laurapreidewe/Agriculture-VCU_v2/UGV Control Unit.kicad_pcb

## KiCad design UGV Control Unit.kicad_pcb (2026-10-22)

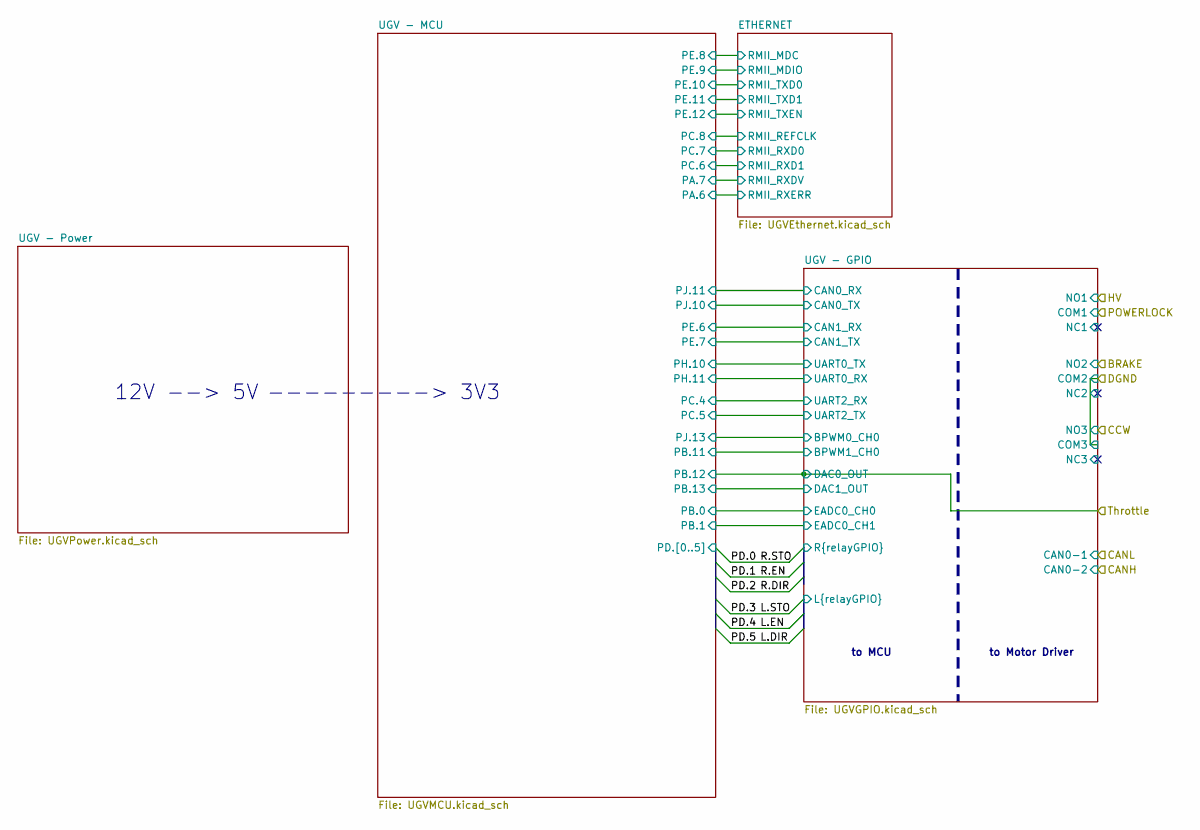
[picture p30: schematic UGV Control Unit.kicad_sch, Agricultural VCU V2]

Notes on the sheet:
to MCU
to Motor Driver
12V --> 5V
---------> 3V3

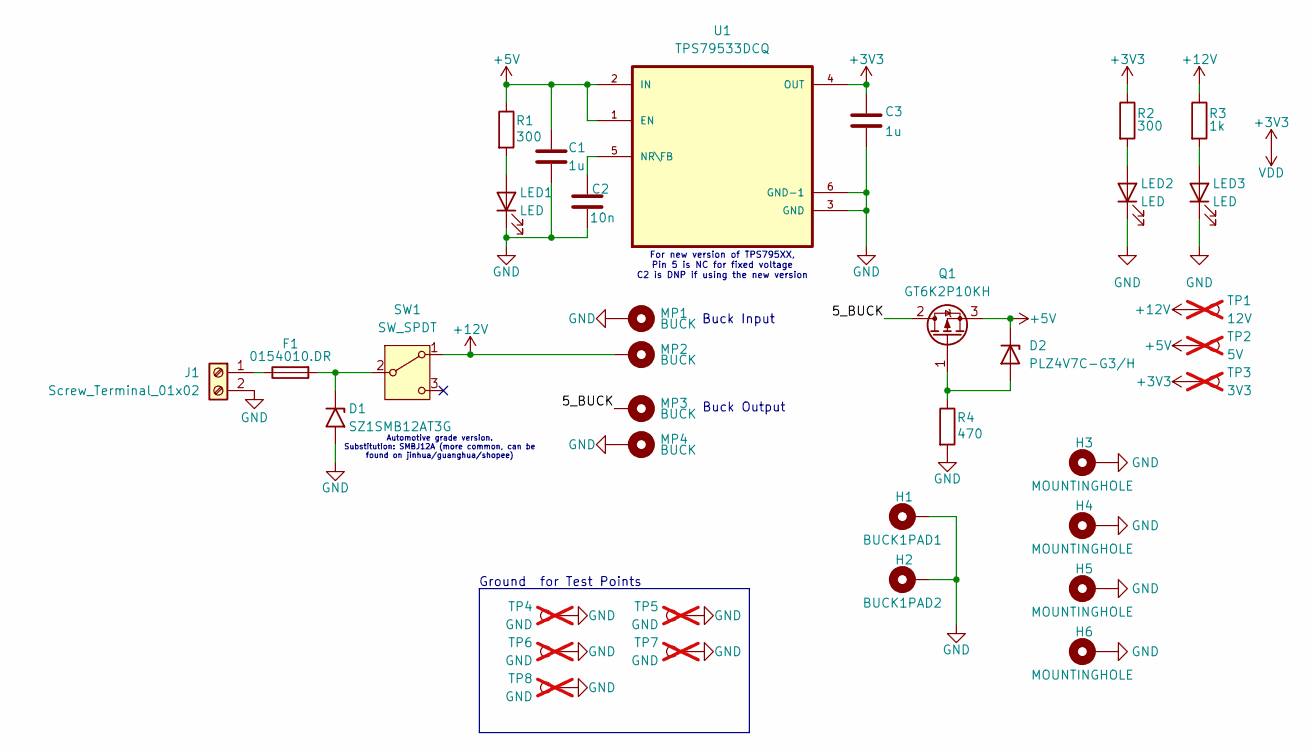
[picture p31: schematic UGVPower.kicad_sch, Agricultural VCU V2 - Power Supply]

Parts:
C1, C3: 1u; C_0603_1608Metric_Pad1.08x0.95mm_HandSolder; MANUFACTURER_PART_NUMBER 0603YC105JAT2A
C2: 10n; C_0603_1608Metric_Pad1.08x0.95mm_HandSolder; MANUFACTURER_PART_NUMBER KGM15AR51E103KT
D1: SZ1SMB12AT3G; D_SMB_Handsoldering; MANUFACTURER_PART_NUMBER SZ1SMB12AT3G
D2: PLZ4V7C-G3/H; CR_PLZ5V1C_VIS-L; MANUFACTURER_PART_NUMBER PLZ4V7C
F1: 0154010.DR; Fuseholder_Littelfuse_Nano2_154x; MANUFACTURER_PART_NUMBER 0154010.DR
H1: BUCK1PAD1; MountingHole_3.2mm_M3_Pad_TopBottom
H2: BUCK1PAD2; MountingHole_3.2mm_M3_Pad_TopBottom
H3, H4, H5, H6: MOUNTINGHOLE; MountingHole_3.2mm_M3_Pad_Via
J1: Screw_Terminal_01x02; TerminalBlock_TE_NC6-P107-02_1x02_P9.53mm; MANUFACTURER_PART_NUMBER 1437664-4
LED1, LED2, LED3: LED; LED_0603_1608Metric_Pad1.05x0.95mm_HandSolder; MANUFACTURER_PART_NUMBER 150060SS75003
MP1, MP2, MP3, MP4: BUCK; MountingHole_4.3mm_M4_Pad_TopBottom; MANUFACTURER_PART_NUMBER 24885
Q1: GT6K2P10KH; TO-252-2; MANUFACTURER_PART_NUMBER GT6K2P10KH
R1, R2: 300; R_0603_1608Metric_Pad0.98x0.95mm_HandSolder; MANUFACTURER_PART_NUMBER RT0603BRD07300RL
R3: 1k; R_0603_1608Metric_Pad0.98x0.95mm_HandSolder; MANUFACTURER_PART_NUMBER RT0603FRE131KL
R4: 470; R_0603_1608Metric_Pad0.98x0.95mm_HandSolder; MANUFACTURER_PART_NUMBER RT0603FRE07470RL
SW1: SW_SPDT; SW_500SSP1S1M2REA; MANUFACTURER_PART_NUMBER 500SSP1S1M2REA
TP1: 12V; TestPoint_Pad_D1.0mm; not fitted
TP2: 5V; TestPoint_Pad_D1.0mm; not fitted
TP3: 3V3; TestPoint_Pad_D1.0mm; not fitted
TP4, TP5, TP6, TP7, TP8: GND; PinHeader_1x01_P2.54mm_Vertical; not fitted
U1: TPS79533DCQ; SOT127P706X180-6N; MANUFACTURER_PART_NUMBER TPS79533DCQ

Connections:
+12V: MP2.1, R3.1, SW1.1 (A), TP1.1; also elsewhere on the board
/UGV - Power/5_BUCK: MP3.1, Q1.2 (D)
GND: C1.2, C2.2, C3.2, D1.2 (A2), H1.1, H2.1, H3.1, H4.1, H5.1, H6.1, J1.2, LED1.1 (K), LED2.1 (K), LED3.1 (K), MP1.1, MP4.1, R4.2, TP4.1, TP5.1, TP6.1, TP7.1, TP8.1, U1.3 (GND), U1.6 (GND-1); also elsewhere on the board
unnamed: D1.1 (A1), F1.2, SW1.2 (B)
unnamed: D2.2 (A), Q1.1 (G), R4.1
unnamed: F1.1, J1.1
unnamed: LED1.2 (A), R1.2
unnamed: LED2.2 (A), R2.2
unnamed: LED3.2 (A), R3.2
unnamed: C2.1, U1.5 (NR\FB)

Notes on the sheet:
Automotive grade version. Substitution: SMBJ12A (more common, can be found on jinhua/guanghua/shopee)
Ground for Test Points
Buck Input
For new version of TPS795XX, Pin 5 is NC for fixed voltage C2 is DNP if using the new version
Buck Output

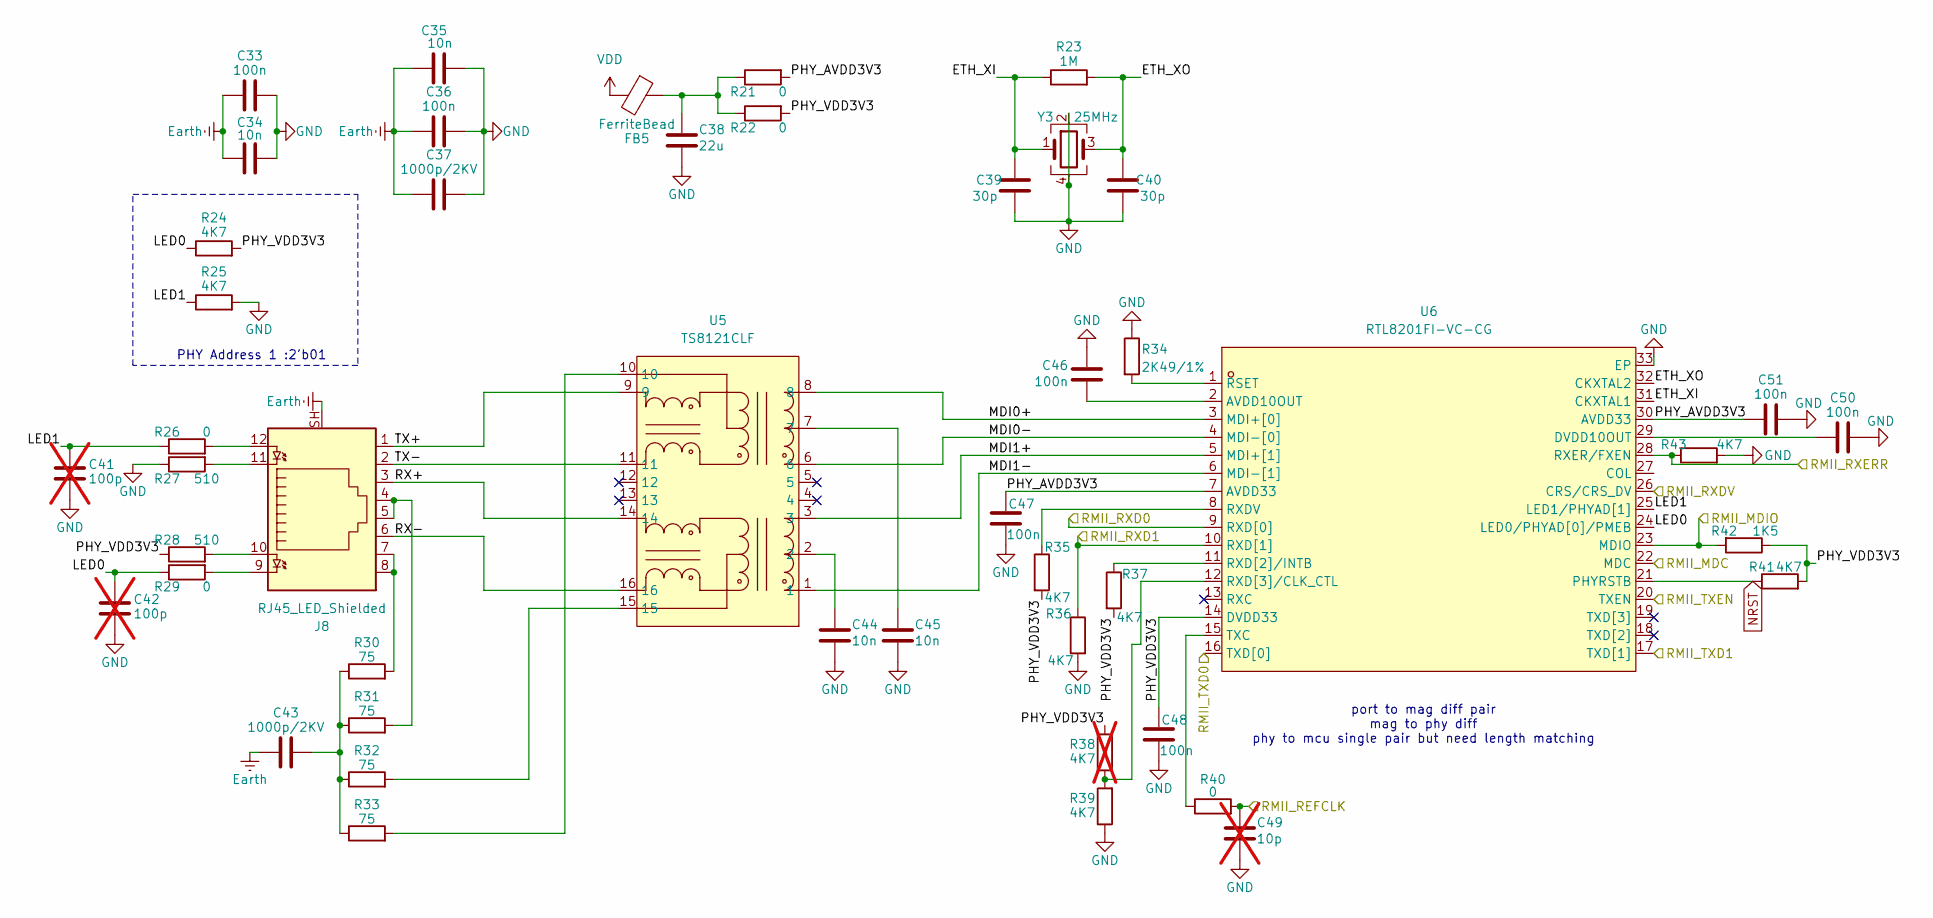
[picture p32: schematic UGVEthernet.kicad_sch, Agricultural VCU V2 - Ethernet]

Parts:
C33, C36, C46, C47, C48, C50, C51: 100n; C_0603_1608Metric_Pad1.08x0.95mm_HandSolder; MANUFACTURER_PART_NUMBER KGM15BR71H104KT
C34, C35, C44, C45: 10n; C_0603_1608Metric_Pad1.08x0.95mm_HandSolder; MANUFACTURER_PART_NUMBER KGM15AR51E103KT
C37, C43: 1000p/2KV; C_1206_3216Metric_Pad1.33x1.80mm_HandSolder; MANUFACTURER_PART_NUMBER CC1206JKX7RDBB102
C38: 22u; C_0603_1608Metric_Pad1.08x0.95mm_HandSolder; MANUFACTURER_PART_NUMBER GRM188R61A226ME15D
C39, C40: 30p; C_0603_1608Metric_Pad1.08x0.95mm_HandSolder; MANUFACTURER_PART_NUMBER 06035A300JAT2A
C41, C42: 100p; C_0603_1608Metric_Pad1.08x0.95mm_HandSolder; MANUFACTURER_PART_NUMBER KGM15ACG1H101FT; not fitted
C49: 10p; C_0603_1608Metric_Pad1.08x0.95mm_HandSolder; MANUFACTURER_PART_NUMBER CC0603JRNPO9BN100; not fitted
FB5: FerriteBead; L_0603_1608Metric_Pad1.05x0.95mm_HandSolder; MANUFACTURER_PART_NUMBER BLM18KG300TN1D
J8: RJ45_LED_Shielded; RJ45_Amphenol_RJHSE538X; MANUFACTURER_PART_NUMBER RJHSE5381
R21, R22, R26, R29, R40: 0; R_0603_1608Metric_Pad0.98x0.95mm_HandSolder; MANUFACTURER_PART_NUMBER RC0603JR-070RL
R23: 1M; R_0603_1608Metric_Pad0.98x0.95mm_HandSolder; MANUFACTURER_PART_NUMBER RC0603FR-101ML
R24, R25, R35, R36, R37, R39, R41, R43: 4K7; R_0603_1608Metric_Pad0.98x0.95mm_HandSolder; MANUFACTURER_PART_NUMBER RC0603FR-134K7L
R27, R28: 510; R_0603_1608Metric_Pad0.98x0.95mm_HandSolder; MANUFACTURER_PART_NUMBER RT0603BRD07510RL
R30, R31, R32, R33: 75; R_0603_1608Metric_Pad0.98x0.95mm_HandSolder; MANUFACTURER_PART_NUMBER RC0603FR-0775RL
R34: 2K49/1%; R_0603_1608Metric_Pad0.98x0.95mm_HandSolder; MANUFACTURER_PART_NUMBER RC0603FR-072K49L
R38: 4K7; R_0603_1608Metric_Pad0.98x0.95mm_HandSolder; MANUFACTURER_PART_NUMBER RC0603FR-134K7L; not fitted
R42: 1K5; R_0603_1608Metric_Pad0.98x0.95mm_HandSolder; MANUFACTURER_PART_NUMBER RT0603FRE071K5L
U5: TS8121CLF; SOP-16_7.0x13.0mm_P1.27mm; MANUFACTURER_PART_NUMBER TS8121CLF; LCSC Part C2839017
U6: RTL8201FI-VC-CG; QFN-32-1EP_5x5mm_P0.5mm_EP3.3x3.3mm_ThermalVias; MANUFACTURER_PART_NUMBER RTL8201FI-VC-CG; LCSC Part C2763557
Y3: 25MHz; Crystal_SMD_SeikoEpson_TSX3225-4Pin_3.2x2.5mm_HandSoldering; MANUFACTURER_PART_NUMBER TSX-3225 25.0000MF10P-C0

Connections:
/ETHERNET/ETH_XI: C39.1, R23.1, U6.31 (CKXTAL1), Y3.1
/ETHERNET/ETH_XO: C40.1, R23.2, U6.32 (CKXTAL2), Y3.3
/ETHERNET/LED0: C42.1, R24.1, R29.1, U6.24 (LED0/PHYAD[0]/PMEB)
/ETHERNET/LED1: C41.1, R25.1, R26.1, U6.25 (LED1/PHYAD[1])
/ETHERNET/MDI0+: U5.8, U6.3 (MDI+[0])
/ETHERNET/MDI0-: U5.6, U6.4 (MDI-[0])
/ETHERNET/MDI1+: U5.3, U6.5 (MDI+[1])
/ETHERNET/MDI1-: U5.1, U6.6 (MDI-[1])
/ETHERNET/PHY_AVDD3V3: C47.1, C51.2, R21.2, U6.7 (AVDD33), U6.30 (AVDD33)
/ETHERNET/PHY_VDD3V3: C48.1, R22.2, R24.2, R28.1, R35.2, R37.2, R38.2, R41.2, R42.1, U6.14 (DVDD33)
/ETHERNET/RX+: J8.3, U5.14
/ETHERNET/RX-: J8.6, U5.16
/ETHERNET/TX+: J8.1, U5.9
/ETHERNET/TX-: J8.2, U5.11
/UGV - MCU/PA.6: R43.1, U6.28 (RXER/FXEN); also elsewhere on the board
/UGV - MCU/PA.7: U6.26 (CRS/CRS_DV); also elsewhere on the board
/UGV - MCU/PC.6: R36.1, U6.10 (RXD[1]); also elsewhere on the board
/UGV - MCU/PC.7: U6.9 (RXD[0]); also elsewhere on the board
/UGV - MCU/PC.8: C49.1, R40.2; also elsewhere on the board
/UGV - MCU/PE.8: U6.22 (MDC); also elsewhere on the board
/UGV - MCU/PE.9: R42.2, U6.23 (MDIO); also elsewhere on the board
/UGV - MCU/PE.10: U6.16 (TXD[0]); also elsewhere on the board
/UGV - MCU/PE.11: U6.17 (TXD[1]); also elsewhere on the board
/UGV - MCU/PE.12: U6.20 (TXEN); also elsewhere on the board
Earth: C33.1, C34.2, C35.1, C36.2, C37.1, C43.1, J8.SH
GND: C33.2, C34.1, C35.2, C36.1, C37.2, C38.2, C39.2, C40.2, C41.2, C42.2, C44.2, C45.2, C46.1, C47.2, C48.2, C49.2, C50.1, C51.1, R25.2, R27.1, R34.1, R36.2, R39.1, R43.2, U6.33 (EP), Y3.2, Y3.4; also elsewhere on the board
NRST: R41.1, U6.21 (PHYRSTB); also elsewhere on the board
unnamed: C38.1, FB5.1, R21.1, R22.1
unnamed: C43.2, R30.1, R31.1, R32.1, R33.1
unnamed: C44.1, U5.2
unnamed: C45.1, U5.7
unnamed: J8.4, J8.5, R31.2
unnamed: J8.7, J8.8, R30.2
unnamed: J8.9, R29.2
unnamed: J8.10, R28.2
unnamed: J8.11, R27.2
unnamed: J8.12, R26.2
unnamed: R32.2, U5.15
unnamed: R33.2, U5.10
unnamed: C46.2, U6.2 (AVDD10OUT)
unnamed: C50.2, U6.29 (DVDD10OUT)
unnamed: R34.2, U6.1 (RSET)
unnamed: R35.1, U6.8 (RXDV)
unnamed: R37.1, U6.11 (RXD[2]/INTB)
unnamed: R38.1, R39.2, U6.12 (RXD[3]/CLK_CTL)
unnamed: R40.1, U6.15 (TXC)

Notes on the sheet:
port to mag diff pair mag to phy diff phy to mcu single pair but need length matching
PHY Address 1 :2'b01

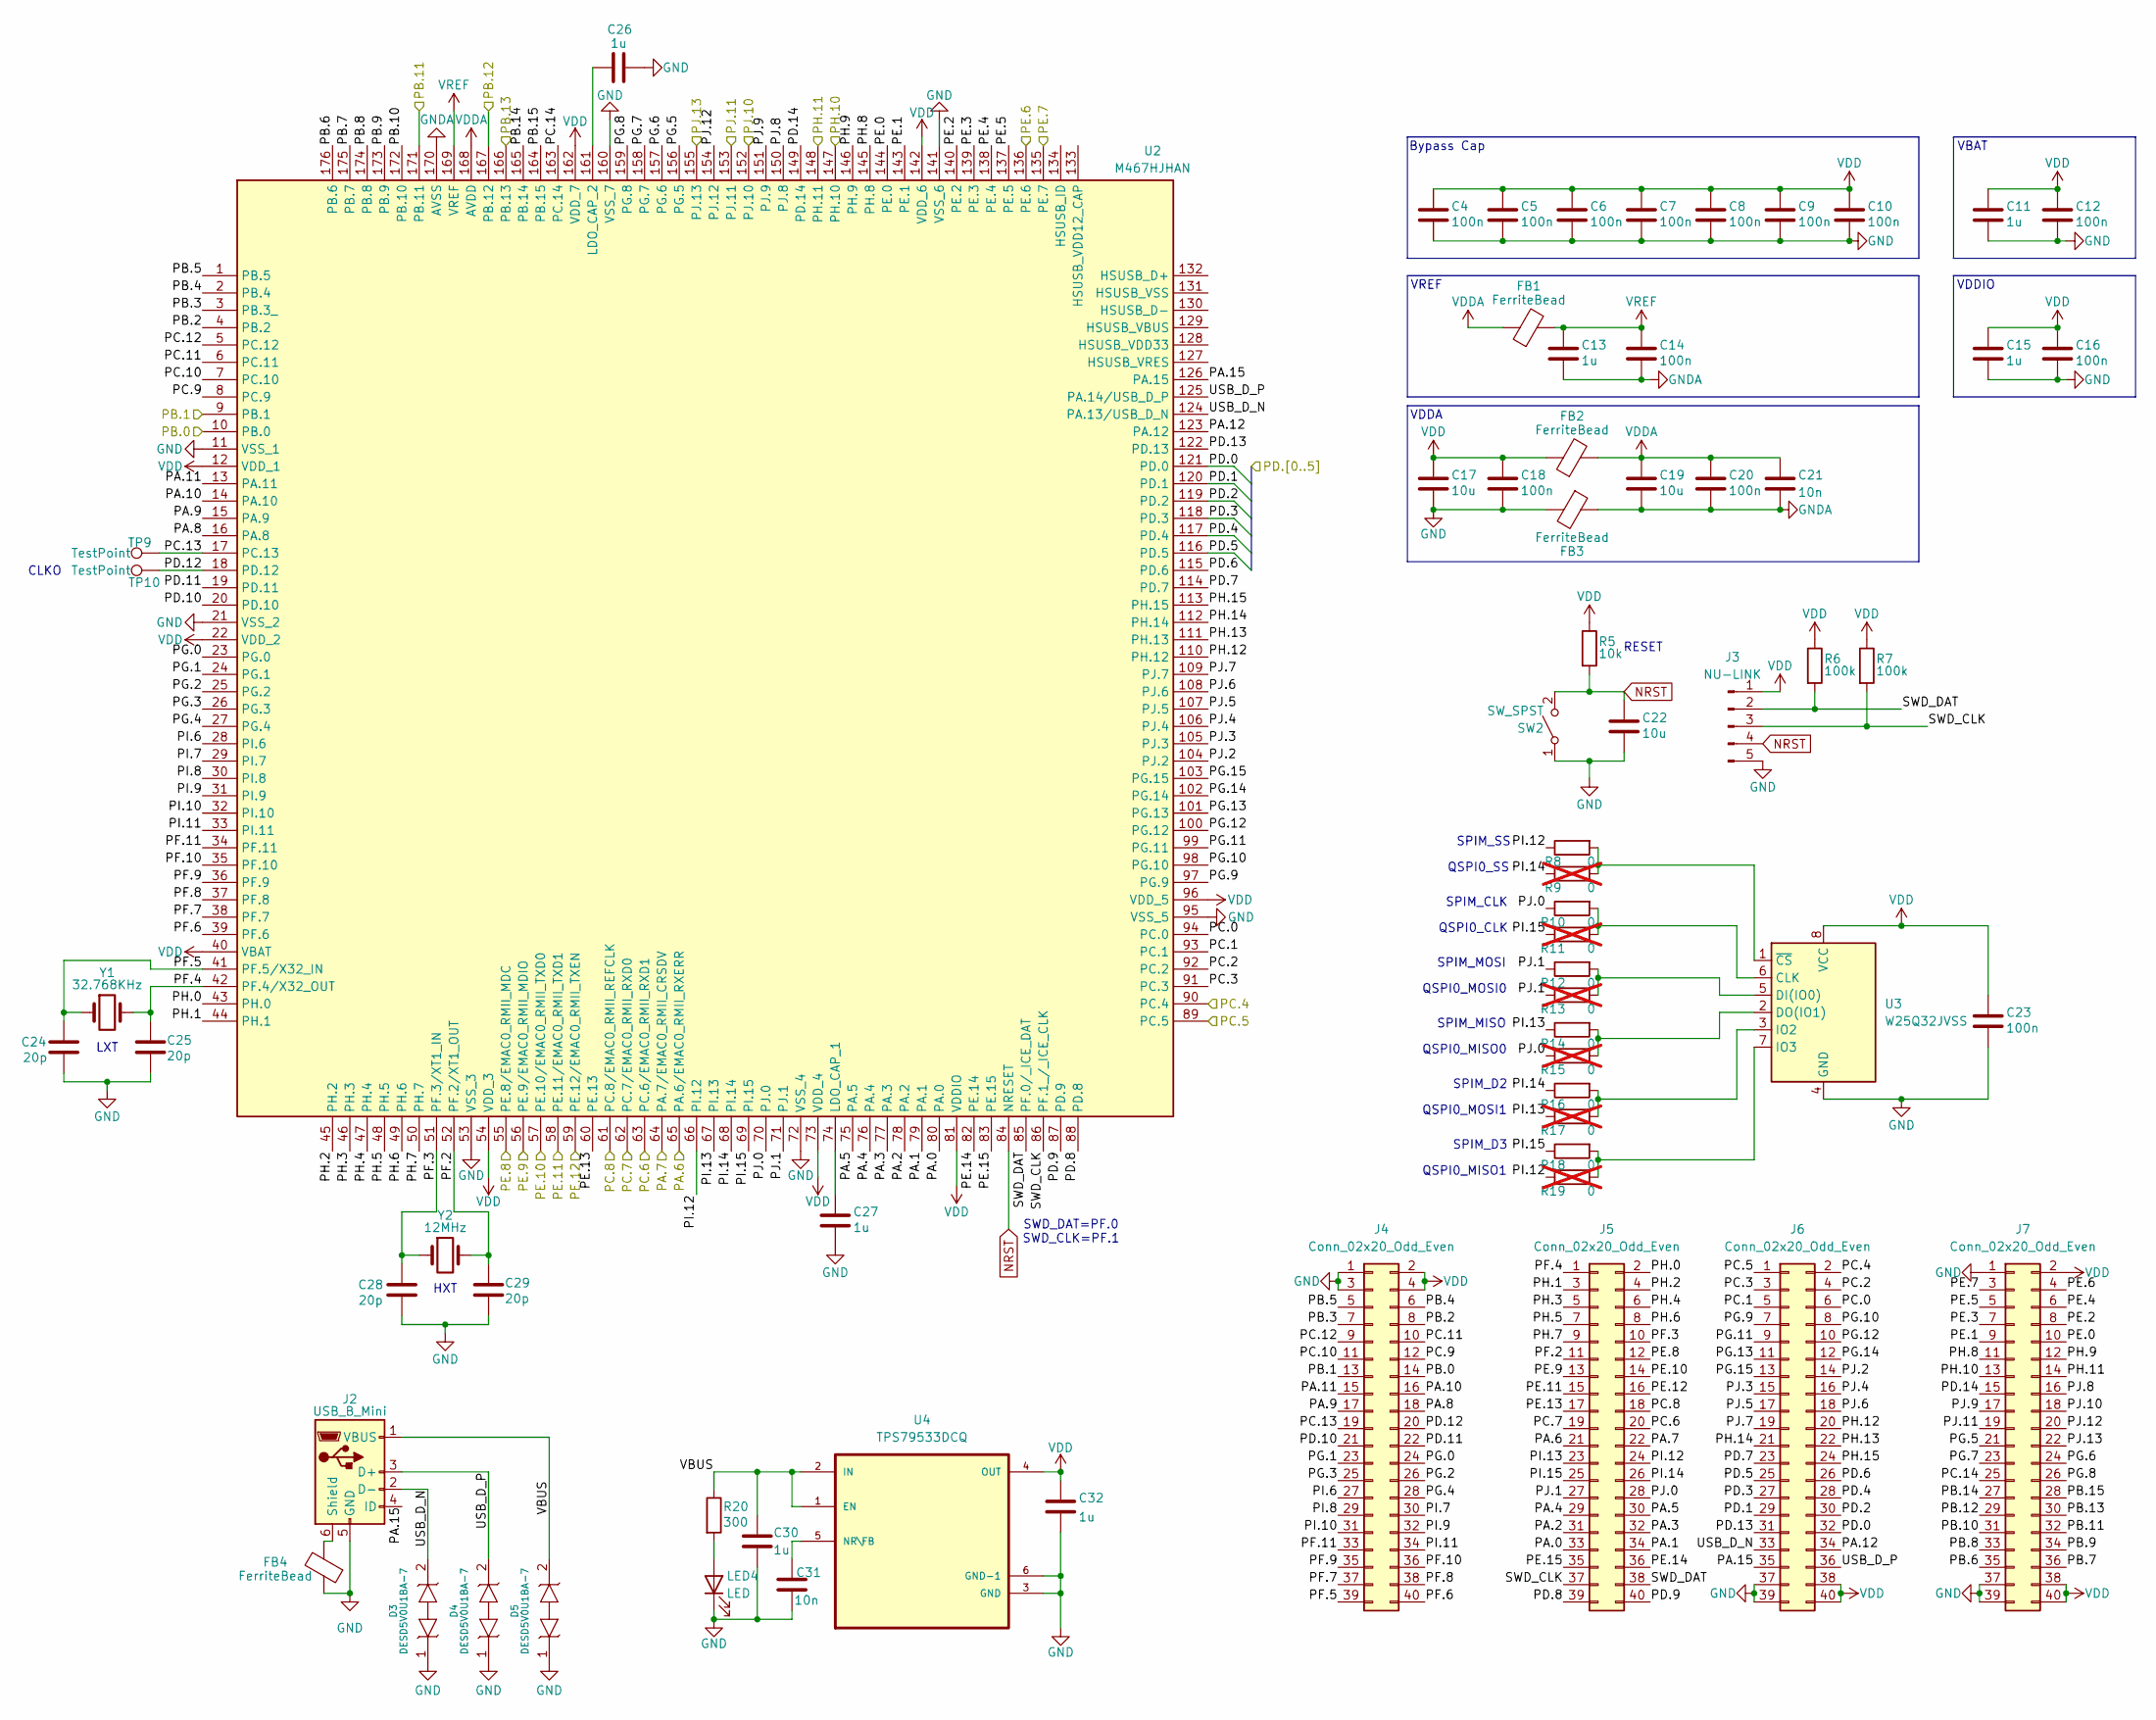
[picture p33: schematic UGVMCU.kicad_sch, Agricultural VCU V2 - MCU]

Parts:
C4, C5, C6, C7, C8, C9, C10, C12, C14, C16, C18, C20, C23: 100n; C_0603_1608Metric_Pad1.08x0.95mm_HandSolder; MANUFACTURER_PART_NUMBER KGM15BR71H104KT
C11, C13, C15, C26, C27, C30, C32: 1u; C_0603_1608Metric_Pad1.08x0.95mm_HandSolder; MANUFACTURER_PART_NUMBER 0603YC105JAT2A
C17, C19, C22: 10u; C_0603_1608Metric_Pad1.08x0.95mm_HandSolder; MANUFACTURER_PART_NUMBER GRM188D71A106KA73D
C21, C31: 10n; C_0603_1608Metric_Pad1.08x0.95mm_HandSolder; MANUFACTURER_PART_NUMBER KGM15AR51E103KT
C24, C25, C28, C29: 20p; C_0603_1608Metric_Pad1.08x0.95mm_HandSolder; MANUFACTURER_PART_NUMBER 06035A200JAT2A
D3, D4, D5: DESD5V0U1BA-7; SOD323-L_DIO; MANUFACTURER_PART_NUMBER DESD5V0U1BA
FB1, FB2, FB3, FB4: FerriteBead; L_0603_1608Metric_Pad1.05x0.95mm_HandSolder; MANUFACTURER_PART_NUMBER BLM18KG300TN1D
J2: USB_B_Mini; USB_Mini-B_Wuerth_65100516121_Horizontal; MANUFACTURER_PART_NUMBER 1734035-3
J3: NU-LINK; PinHeader_1x05_P2.54mm_Vertical; MANUFACTURER_PART_NUMBER PH1-05-UA
J4, J5, J6, J7: Conn_02x20_Odd_Even; PinSocket_2x20_P2.54mm_Vertical
LED4: LED; LED_0603_1608Metric_Pad1.05x0.95mm_HandSolder; MANUFACTURER_PART_NUMBER 150060SS75003
R5: 10k; R_0603_1608Metric_Pad0.98x0.95mm_HandSolder; MANUFACTURER_PART_NUMBER RT0603FRE0710KL
R6, R7: 100k; R_0603_1608Metric_Pad0.98x0.95mm_HandSolder; MANUFACTURER_PART_NUMBER RT0603BRE07100KL
R8, R10, R12, R14, R16, R18: 0; R_0603_1608Metric_Pad0.98x0.95mm_HandSolder; MANUFACTURER_PART_NUMBER RC0603JR-070RL
R9, R11, R13, R15, R17, R19: 0; R_0603_1608Metric_Pad0.98x0.95mm_HandSolder; MANUFACTURER_PART_NUMBER RC0603JR-070RL; not fitted
R20: 300; R_0603_1608Metric_Pad0.98x0.95mm_HandSolder; MANUFACTURER_PART_NUMBER RT0603BRD07300RL
SW2: SW_SPST; SW_PUSH_6mm; MANUFACTURER_PART_NUMBER TL1105F160QWITHSTRAIGHT
TP9, TP10: TestPoint; PinHeader_1x01_P2.54mm_Vertical
U2: M467HJHAN; LQFP-176_24x24mm_P0.5mm; Manufacturer_Part_Number M467HJHAN
U3: W25Q32JVSS; SOIC-8_5.23x5.23mm_P1.27mm; MANUFACTURER_PART_NUMBER W25Q32JVSSIQ
U4: TPS79533DCQ; SOT127P706X180-6N; MANUFACTURER_PART_NUMBER TPS79533DCQ
Y1: 32.768KHz; Crystal_SMD_EuroQuartz_EQ161-2Pin_3.2x1.5mm_HandSoldering; MANUFACTURER_PART_NUMBER ABS07-32.768KHZ-T
Y2: 12MHz; Crystal_HC49-4H_Vertical

Connections:
/UGV - GPIO/CAN0_RX: J7.19, U2.153 (PJ.11); also elsewhere on the board
/UGV - GPIO/CAN0_TX: J7.18, U2.152 (PJ.10); also elsewhere on the board
/UGV - GPIO/CAN1_RX: J7.4, U2.136 (PE.6); also elsewhere on the board
/UGV - GPIO/CAN1_TX: J7.3, U2.135 (PE.7); also elsewhere on the board
/UGV - GPIO/L.DIR: J6.25, U2.116 (PD.5); also elsewhere on the board
/UGV - GPIO/L.EN: J6.28, U2.117 (PD.4); also elsewhere on the board
/UGV - GPIO/L.STO: J6.27, U2.118 (PD.3); also elsewhere on the board
/UGV - GPIO/UART0_RX: J7.14, U2.148 (PH.11); also elsewhere on the board
/UGV - GPIO/UART0_TX: J7.13, U2.147 (PH.10); also elsewhere on the board
/UGV - GPIO/UART2_RX: J6.2, U2.90 (PC.4); also elsewhere on the board
/UGV - GPIO/UART2_TX: J6.1, U2.89 (PC.5); also elsewhere on the board
/UGV - MCU/PA.0: J5.33, U2.80 (PA.0)
/UGV - MCU/PA.1: J5.34, U2.79 (PA.1)
/UGV - MCU/PA.2: J5.31, U2.78 (PA.2)
/UGV - MCU/PA.3: J5.32, U2.77 (PA.3)
/UGV - MCU/PA.4: J5.29, U2.76 (PA.4)
/UGV - MCU/PA.5: J5.30, U2.75 (PA.5)
/UGV - MCU/PA.6: J5.21, U2.65 (PA.6/EMAC0_RMII_RXERR); also elsewhere on the board
/UGV - MCU/PA.7: J5.22, U2.64 (PA.7/EMAC0_RMII_CRSDV); also elsewhere on the board
/UGV - MCU/PA.8: J4.18, U2.16 (PA.8)
/UGV - MCU/PA.9: J4.17, U2.15 (PA.9)
/UGV - MCU/PA.10: J4.16, U2.14 (PA.10)
/UGV - MCU/PA.11: J4.15, U2.13 (PA.11)
/UGV - MCU/PA.12: J6.34, U2.123 (PA.12)
/UGV - MCU/PA.15: J2.4 (ID), J6.35, U2.126 (PA.15)
/UGV - MCU/PB.0: J4.14, U2.10 (PB.0); also elsewhere on the board
/UGV - MCU/PB.1: J4.13, U2.9 (PB.1); also elsewhere on the board
/UGV - MCU/PB.2: J4.8, U2.4 (PB.2)
/UGV - MCU/PB.3: J4.7, U2.3 (PB.3_)
/UGV - MCU/PB.4: J4.6, U2.2 (PB.4)
/UGV - MCU/PB.5: J4.5, U2.1 (PB.5)
/UGV - MCU/PB.6: J7.35, U2.176 (PB.6)
/UGV - MCU/PB.7: J7.36, U2.175 (PB.7)
/UGV - MCU/PB.8: J7.33, U2.174 (PB.8)
/UGV - MCU/PB.9: J7.34, U2.173 (PB.9)
/UGV - MCU/PB.10: J7.31, U2.172 (PB.10)
/UGV - MCU/PB.11: J7.32, U2.171 (PB.11); also elsewhere on the board
/UGV - MCU/PB.12: J7.29, U2.167 (PB.12); also elsewhere on the board
/UGV - MCU/PB.13: J7.30, U2.166 (PB.13); also elsewhere on the board
/UGV - MCU/PB.14: J7.27, U2.165 (PB.14)
/UGV - MCU/PB.15: J7.28, U2.164 (PB.15)
/UGV - MCU/PC.0: J6.6, U2.94 (PC.0)
/UGV - MCU/PC.1: J6.5, U2.93 (PC.1)
/UGV - MCU/PC.2: J6.4, U2.92 (PC.2)
/UGV - MCU/PC.3: J6.3, U2.91 (PC.3)
/UGV - MCU/PC.6: J5.20, U2.63 (PC.6/EMAC0_RMII_RXD1); also elsewhere on the board
/UGV - MCU/PC.7: J5.19, U2.62 (PC.7/EMAC0_RMII_RXD0); also elsewhere on the board
/UGV - MCU/PC.8: J5.18, U2.61 (PC.8/EMAC0_RMII_REFCLK); also elsewhere on the board
/UGV - MCU/PC.9: J4.12, U2.8 (PC.9)
/UGV - MCU/PC.10: J4.11, U2.7 (PC.10)
/UGV - MCU/PC.11: J4.10, U2.6 (PC.11)
/UGV - MCU/PC.12: J4.9, U2.5 (PC.12)
/UGV - MCU/PC.13: J4.19, TP9.1, U2.17 (PC.13)
/UGV - MCU/PC.14: J7.25, U2.163 (PC.14)
/UGV - MCU/PD.0: J6.32, U2.121 (PD.0); also elsewhere on the board
/UGV - MCU/PD.1: J6.29, U2.120 (PD.1); also elsewhere on the board
/UGV - MCU/PD.2: J6.30, U2.119 (PD.2); also elsewhere on the board
/UGV - MCU/PD.6: J6.26, U2.115 (PD.6)
/UGV - MCU/PD.7: J6.23, U2.114 (PD.7)
/UGV - MCU/PD.8: J5.39, U2.88 (PD.8)
/UGV - MCU/PD.9: J5.40, U2.87 (PD.9)
/UGV - MCU/PD.10: J4.21, U2.20 (PD.10)
/UGV - MCU/PD.11: J4.22, U2.19 (PD.11)
/UGV - MCU/PD.12: J4.20, TP10.1, U2.18 (PD.12)
/UGV - MCU/PD.13: J6.31, U2.122 (PD.13)
/UGV - MCU/PD.14: J7.15, U2.149 (PD.14)
/UGV - MCU/PE.0: J7.10, U2.144 (PE.0)
/UGV - MCU/PE.1: J7.9, U2.143 (PE.1)
/UGV - MCU/PE.2: J7.8, U2.140 (PE.2)
/UGV - MCU/PE.3: J7.7, U2.139 (PE.3)
/UGV - MCU/PE.4: J7.6, U2.138 (PE.4)
/UGV - MCU/PE.5: J7.5, U2.137 (PE.5)
/UGV - MCU/PE.8: J5.12, U2.55 (PE.8/EMAC0_RMII_MDC); also elsewhere on the board
/UGV - MCU/PE.9: J5.13, U2.56 (PE.9/EMAC0_RMII_MDIO); also elsewhere on the board
/UGV - MCU/PE.10: J5.14, U2.57 (PE.10/EMAC0_RMII_TXD0); also elsewhere on the board
/UGV - MCU/PE.11: J5.15, U2.58 (PE.11/EMAC0_RMII_TXD1); also elsewhere on the board
/UGV - MCU/PE.12: J5.16, U2.59 (PE.12/EMAC0_RMII_TXEN); also elsewhere on the board
/UGV - MCU/PE.13: J5.17, U2.60 (PE.13)
/UGV - MCU/PE.14: J5.36, U2.82 (PE.14)
/UGV - MCU/PE.15: J5.35, U2.83 (PE.15)
/UGV - MCU/PF.2: C29.1, J5.11, U2.52 (PF.2/XT1_OUT), Y2.2
/UGV - MCU/PF.3: C28.1, J5.10, U2.51 (PF.3/XT1_IN), Y2.1
/UGV - MCU/PF.4: C25.1, J5.1, U2.42 (PF.4/X32_OUT), Y1.2
/UGV - MCU/PF.5: C24.1, J4.39, U2.41 (PF.5/X32_IN), Y1.1
/UGV - MCU/PF.6: J4.40, U2.39 (PF.6)
/UGV - MCU/PF.7: J4.37, U2.38 (PF.7)
/UGV - MCU/PF.8: J4.38, U2.37 (PF.8)
/UGV - MCU/PF.9: J4.35, U2.36 (PF.9)
/UGV - MCU/PF.10: J4.36, U2.35 (PF.10)
/UGV - MCU/PF.11: J4.33, U2.34 (PF.11)
/UGV - MCU/PG.0: J4.24, U2.23 (PG.0)
/UGV - MCU/PG.1: J4.23, U2.24 (PG.1)
/UGV - MCU/PG.2: J4.26, U2.25 (PG.2)
/UGV - MCU/PG.3: J4.25, U2.26 (PG.3)
/UGV - MCU/PG.4: J4.28, U2.27 (PG.4)
/UGV - MCU/PG.5: J7.21, U2.156 (PG.5)
/UGV - MCU/PG.6: J7.24, U2.157 (PG.6)
/UGV - MCU/PG.7: J7.23, U2.158 (PG.7)
/UGV - MCU/PG.8: J7.26, U2.159 (PG.8)
/UGV - MCU/PG.9: J6.7, U2.97 (PG.9)
/UGV - MCU/PG.10: J6.8, U2.98 (PG.10)
/UGV - MCU/PG.11: J6.9, U2.99 (PG.11)
/UGV - MCU/PG.12: J6.10, U2.100 (PG.12)
/UGV - MCU/PG.13: J6.11, U2.101 (PG.13)
/UGV - MCU/PG.14: J6.12, U2.102 (PG.14)
/UGV - MCU/PG.15: J6.13, U2.103 (PG.15)
/UGV - MCU/PH.0: J5.2, U2.43 (PH.0)
/UGV - MCU/PH.1: J5.3, U2.44 (PH.1)
/UGV - MCU/PH.2: J5.4, U2.45 (PH.2)
/UGV - MCU/PH.3: J5.5, U2.46 (PH.3)
/UGV - MCU/PH.4: J5.6, U2.47 (PH.4)
/UGV - MCU/PH.5: J5.7, U2.48 (PH.5)
/UGV - MCU/PH.6: J5.8, U2.49 (PH.6)
/UGV - MCU/PH.7: J5.9, U2.50 (PH.7)
/UGV - MCU/PH.8: J7.11, U2.145 (PH.8)
/UGV - MCU/PH.9: J7.12, U2.146 (PH.9)
/UGV - MCU/PH.12: J6.20, U2.110 (PH.12)
/UGV - MCU/PH.13: J6.22, U2.111 (PH.13)
/UGV - MCU/PH.14: J6.21, U2.112 (PH.14)
/UGV - MCU/PH.15: J6.24, U2.113 (PH.15)
/UGV - MCU/PI.6: J4.27, U2.28 (PI.6)
/UGV - MCU/PI.7: J4.30, U2.29 (PI.7)
/UGV - MCU/PI.8: J4.29, U2.30 (PI.8)
/UGV - MCU/PI.9: J4.32, U2.31 (PI.9)
/UGV - MCU/PI.10: J4.31, U2.32 (PI.10)
/UGV - MCU/PI.11: J4.34, U2.33 (PI.11)
/UGV - MCU/PI.12: J5.24, R8.1, R19.1, U2.66 (PI.12)
/UGV - MCU/PI.13: J5.23, R14.1, R17.1, U2.67 (PI.13)
/UGV - MCU/PI.14: J5.26, R9.1, R16.1, U2.68 (PI.14)
/UGV - MCU/PI.15: J5.25, R11.1, R18.1, U2.69 (PI.15)
/UGV - MCU/PJ.0: J5.28, R10.1, R15.1, U2.70 (PJ.0)
/UGV - MCU/PJ.1: J5.27, R12.1, R13.1, U2.71 (PJ.1)
/UGV - MCU/PJ.2: J6.14, U2.104 (PJ.2)
/UGV - MCU/PJ.3: J6.15, U2.105 (PJ.3)
/UGV - MCU/PJ.4: J6.16, U2.106 (PJ.4)
/UGV - MCU/PJ.5: J6.17, U2.107 (PJ.5)
/UGV - MCU/PJ.6: J6.18, U2.108 (PJ.6)
/UGV - MCU/PJ.7: J6.19, U2.109 (PJ.7)
/UGV - MCU/PJ.8: J7.16, U2.150 (PJ.8)
/UGV - MCU/PJ.9: J7.17, U2.151 (PJ.9)
/UGV - MCU/PJ.12: J7.20, U2.154 (PJ.12)
/UGV - MCU/PJ.13: J7.22, U2.155 (PJ.13); also elsewhere on the board
/UGV - MCU/SWD_CLK: J3.3, J5.37, R7.2, U2.86 (PF.1_/_ICE_CLK)
/UGV - MCU/SWD_DAT: J3.2, J5.38, R6.2, U2.85 (PF.0/_ICE_DAT)
/UGV - MCU/USB_D_N: D3.2, J2.2 (D-), J6.33, U2.124 (PA.13/USB_D_N)
/UGV - MCU/USB_D_P: D4.2, J2.3 (D+), J6.36, U2.125 (PA.14/USB_D_P)
/UGV - MCU/VBUS: C30.1, D5.2, J2.1 (VBUS), R20.1, U4.1 (EN), U4.2 (IN)
GND: C4.2, C5.2, C6.2, C7.2, C8.2, C9.2, C10.2, C11.2, C12.2, C15.2, C16.2, C17.2, C18.2, C22.2, C23.2, C24.2, C25.2, C26.1, C27.2, C28.2, C29.2, C30.2, C31.2, C32.2, D3.1, D4.1, D5.1, FB3.2, FB4.1, J2.5 (GND), J3.5, J4.1, J4.3, J6.37, J6.39, J7.1, J7.37, J7.39, LED4.1 (K), SW2.1 (A), U2.11 (VSS_1), U2.21 (VSS_2), U2.53 (VSS_3), U2.72 (VSS_4), U2.95 (VSS_5), U2.141 (VSS_6), U2.160 (VSS_7), U3.4 (GND), U4.3 (GND), U4.6 (GND-1); also elsewhere on the board
GNDA: C13.2, C14.2, C19.2, C20.2, C21.2, FB3.1, U2.170 (AVSS)
NRST: C22.1, J3.4, R5.2, SW2.2 (B), U2.84 (NRESET); also elsewhere on the board
unnamed: FB4.2, J2.6 (Shield)
unnamed: LED4.2 (A), R20.2
unnamed: C27.1, U2.74 (LDO_CAP_1)
unnamed: C26.2, U2.161 (LDO_CAP_2)
unnamed: R10.2, R11.2, U3.6 (CLK)
unnamed: R12.2, R13.2, U3.5 (DI(IO0))
unnamed: R14.2, R15.2, U3.2 (DO(IO1))
unnamed: R16.2, R17.2, U3.3 (IO2)
unnamed: R18.2, R19.2, U3.7 (IO3)
unnamed: R8.2, R9.2, U3.1 (~CS)
unnamed: C31.1, U4.5 (NR\FB)
VDDA: C19.1, C20.1, C21.1, FB1.1, FB2.2, U2.168 (AVDD)
VREF: C13.1, C14.1, FB1.2, U2.169 (VREF)

Notes on the sheet:
Bypass Cap
LXT
QSPI0_SS
VBAT
QSPI0_MOSI1
SPIM_CLK
CLKO
VREF
QSPI0_MISO0
QSPI0_CLK
SPIM_SS
SPIM_MISO
SPIM_D2
QSPI0_MISO1
VDDIO
VDDA
HXT
SPIM_MOSI
RESET
SPIM_D3
SWD_DAT=PF.0 SWD_CLK=PF.1
QSPI0_MOSI0
