laurapreidewe/Agriculture-VCU_v2/UGV Control Unit.kicad_pcb

## KiCad design UGV Control Unit.kicad_pcb (continued)

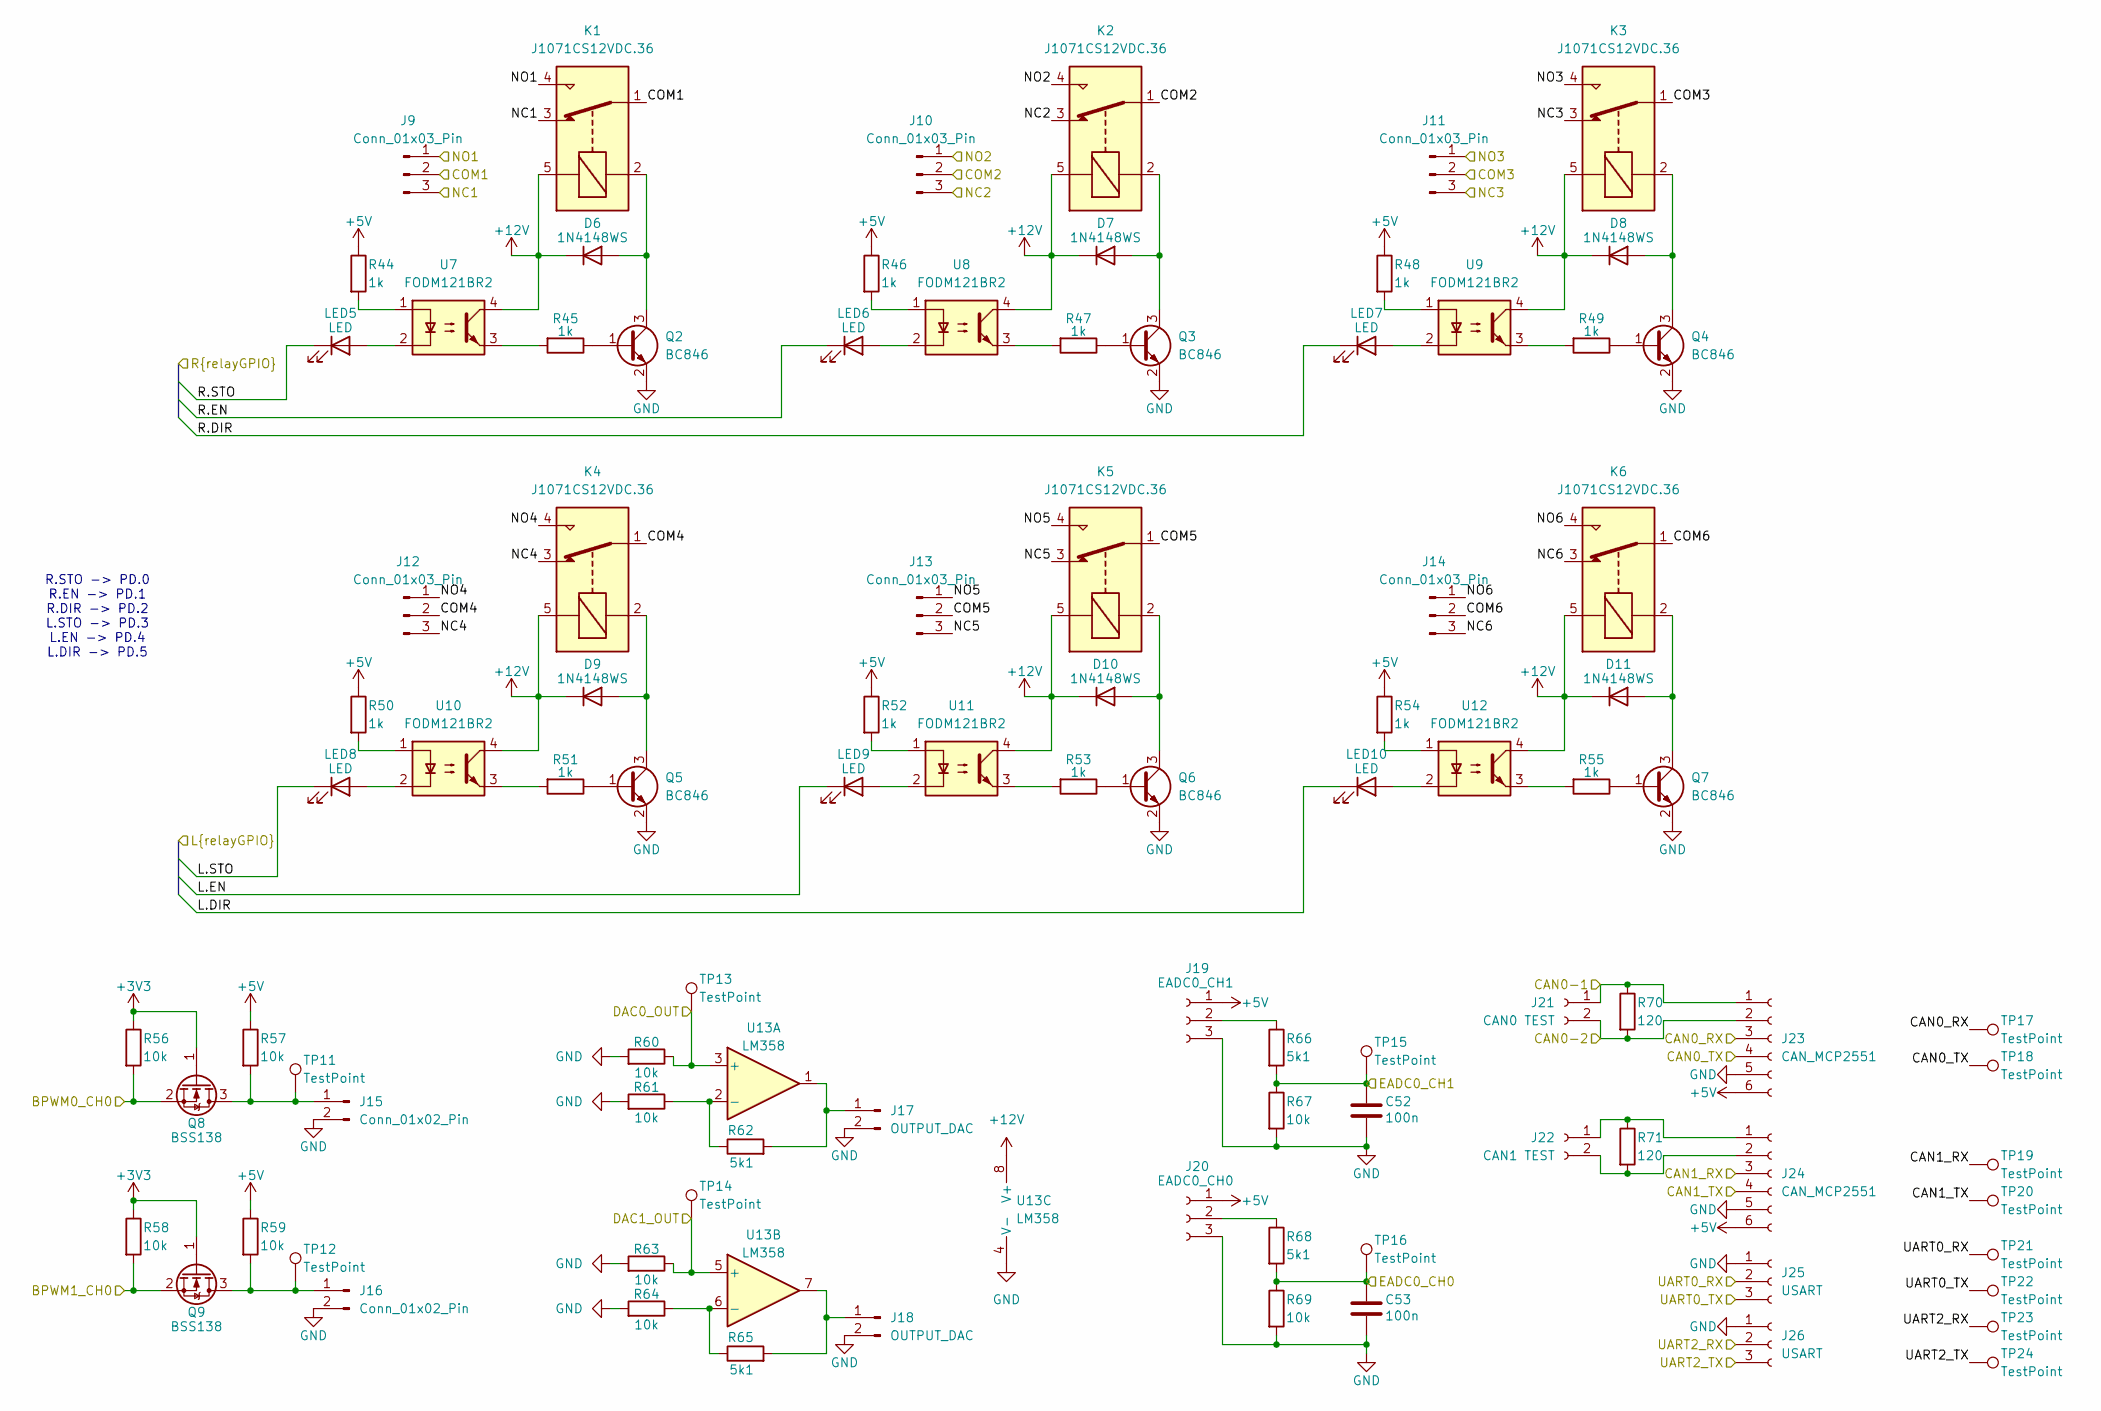
[picture p34: schematic UGVGPIO.kicad_sch, Agricultural VCU V2 - GPIO]

Parts:
C52, C53: 100n; C_0603_1608Metric_Pad1.08x0.95mm_HandSolder; MANUFACTURER_PART_NUMBER KGM15BR71H104KT
D6, D7, D8, D9, D10, D11: 1N4148WS; D_SOD-323; MANUFACTURER_PART_NUMBER 1N4148WS
J9, J10, J11, J12, J13, J14: Conn_01x03_Pin; Wuerth_TBL_691137710003_1x03_P5mm; MANUFACTURER_PART_NUMBER 691137710003
J15, J16: Conn_01x02_Pin; Molex_SL_171971-0002_1x02_P2.54mm_Vertical; MANUFACTURER_PART_NUMBER 1719710002
J17, J18: OUTPUT_DAC; Molex_SL_171971-0002_1x02_P2.54mm_Vertical; MANUFACTURER_PART_NUMBER 1719710002
J19: EADC0_CH1; Molex_SL_171971-0003_1x03_P2.54mm_Vertical; MANUFACTURER_PART_NUMBER 1719710003
J20: EADC0_CH0; Molex_SL_171971-0003_1x03_P2.54mm_Vertical; MANUFACTURER_PART_NUMBER 1719710003
J21: CAN0 TEST; Wuerth_TBL_691137710002_1x02_P5mm; MANUFACTURER_PART_NUMBER 691137710002
J22: CAN1 TEST; Wuerth_TBL_691137710002_1x02_P5mm; MANUFACTURER_PART_NUMBER 691137710002
J23, J24: CAN_MCP2551; PinSocket_1x06_P2.54mm_Vertical; MANUFACTURER_PART_NUMBER 61300611821
J25, J26: USART; Molex_SL_171971-0003_1x03_P2.54mm_Vertical; MANUFACTURER_PART_NUMBER 1719710003
K1, K2, K3, K4, K5, K6: J1071CS12VDC.36; Relay_SPDT_J1071CSXXVDC.36; MANUFACTURER_PART_NUMBER J1071CS12VDC.36
LED5, LED6, LED7, LED8, LED9, LED10: LED; LED_0603_1608Metric_Pad1.05x0.95mm_HandSolder; MANUFACTURER_PART_NUMBER 150060SS75003
Q2, Q3, Q4, Q5, Q6, Q7: BC846; SOT-23; MANUFACTURER_PART_NUMBER BC846,215
Q8, Q9: BSS138; SOT-23; MANUFACTURER_PART_NUMBER BSS138
R44, R45, R46, R47, R48, R49, R50, R51, R52, R53, R54, R55: 1k; R_0603_1608Metric_Pad0.98x0.95mm_HandSolder; MANUFACTURER_PART_NUMBER RT0603FRE131KL
R56, R57, R58, R59, R60, R61, R63, R64, R67, R69: 10k; R_0603_1608Metric_Pad0.98x0.95mm_HandSolder; MANUFACTURER_PART_NUMBER RT0603FRE0710KL
R62, R65, R66, R68: 5k1; R_0603_1608Metric_Pad0.98x0.95mm_HandSolder; MANUFACTURER_PART_NUMBER RT0603BRD075K1L
R70, R71: 120; R_0603_1608Metric_Pad0.98x0.95mm_HandSolder; MANUFACTURER_PART_NUMBER RT0603FRE13120RL
TP11, TP12, TP13, TP14, TP15, TP16, TP17, TP18, TP19, TP20, TP21, TP22, TP23, TP24: TestPoint; PinHeader_1x01_P2.54mm_Vertical
U7, U8, U9, U10, U11, U12: FODM121BR2; MFSOP6-4_4.4x3.6mm_P1.27mm; MANUFACTURER_PART_NUMBER FODM121BR2
U13: LM358; SOIC-8_3.9x4.9mm_P1.27mm; MANUFACTURER_PART_NUMBER LM358M/NOPB

Connections:
+12V: D6.1 (K), D7.1 (K), D8.1 (K), D9.1 (K), D10.1 (K), D11.1 (K), K1.5, K2.5, K3.5, K4.5, K5.5, K6.5, U7.4, U8.4, U9.4, U10.4, U11.4, U12.4, U13.8 (V+); also elsewhere on the board
/UGV - GPIO/CAN0_RX: J23.3, TP17.1; also elsewhere on the board
/UGV - GPIO/CAN0_TX: J23.4, TP18.1; also elsewhere on the board
/UGV - GPIO/CAN1_RX: J24.3, TP19.1; also elsewhere on the board
/UGV - GPIO/CAN1_TX: J24.4, TP20.1; also elsewhere on the board
/UGV - GPIO/COM1: J9.2, K1.1
/UGV - GPIO/COM2: J10.2, K2.1
/UGV - GPIO/COM3: J11.2, K3.1
/UGV - GPIO/COM4: J12.2, K4.1
/UGV - GPIO/COM5: J13.2, K5.1
/UGV - GPIO/COM6: J14.2, K6.1
/UGV - GPIO/L.DIR: LED10.1 (K); also elsewhere on the board
/UGV - GPIO/L.EN: LED9.1 (K); also elsewhere on the board
/UGV - GPIO/L.STO: LED8.1 (K); also elsewhere on the board
/UGV - GPIO/NC1: J9.3, K1.3
/UGV - GPIO/NC2: J10.3, K2.3
/UGV - GPIO/NC3: J11.3, K3.3
/UGV - GPIO/NC4: J12.3, K4.3
/UGV - GPIO/NC5: J13.3, K5.3
/UGV - GPIO/NC6: J14.3, K6.3
/UGV - GPIO/NO1: J9.1, K1.4
/UGV - GPIO/NO2: J10.1, K2.4
/UGV - GPIO/NO3: J11.1, K3.4
/UGV - GPIO/NO4: J12.1, K4.4
/UGV - GPIO/NO5: J13.1, K5.4
/UGV - GPIO/NO6: J14.1, K6.4
/UGV - GPIO/UART0_RX: J25.2, TP21.1; also elsewhere on the board
/UGV - GPIO/UART0_TX: J25.3, TP22.1; also elsewhere on the board
/UGV - GPIO/UART2_RX: J26.2, TP23.1; also elsewhere on the board
/UGV - GPIO/UART2_TX: J26.3, TP24.1; also elsewhere on the board
/UGV - MCU/PB.0: C53.1, R68.2, R69.1, TP16.1; also elsewhere on the board
/UGV - MCU/PB.1: C52.1, R66.2, R67.1, TP15.1; also elsewhere on the board
/UGV - MCU/PB.11: Q9.2 (S), R58.2; also elsewhere on the board
/UGV - MCU/PB.12: R60.1, TP13.1, U13.3 (+); also elsewhere on the board
/UGV - MCU/PB.13: R63.1, TP14.1, U13.5 (+); also elsewhere on the board
/UGV - MCU/PD.0: LED5.1 (K); also elsewhere on the board
/UGV - MCU/PD.1: LED6.1 (K); also elsewhere on the board
/UGV - MCU/PD.2: LED7.1 (K); also elsewhere on the board
/UGV - MCU/PJ.13: Q8.2 (S), R56.2; also elsewhere on the board
GND: C52.2, C53.2, J15.2, J16.2, J17.2, J18.2, J19.3, J20.3, J23.5, J24.5, J25.1, J26.1, Q2.2 (E), Q3.2 (E), Q4.2 (E), Q5.2 (E), Q6.2 (E), Q7.2 (E), R60.2, R61.2, R63.2, R64.2, R67.2, R69.2, U13.4 (V-); also elsewhere on the board
unnamed: D6.2 (A), K1.2, Q2.3 (C)
unnamed: D7.2 (A), K2.2, Q3.3 (C)
unnamed: D8.2 (A), K3.2, Q4.3 (C)
unnamed: D9.2 (A), K4.2, Q5.3 (C)
unnamed: D10.2 (A), K5.2, Q6.3 (C)
unnamed: D11.2 (A), K6.2, Q7.3 (C)
unnamed: J15.1, Q8.3 (D), R57.2, TP11.1
unnamed: J16.1, Q9.3 (D), R59.2, TP12.1
unnamed: J17.1, R62.2, U13.1
unnamed: J18.1, R65.2, U13.7
unnamed: J19.2, R66.1
unnamed: J20.2, R68.1
unnamed: J21.1, J23.1, R70.1
unnamed: J21.2, J23.2, R70.2
unnamed: J22.1, J24.1, R71.1
unnamed: J22.2, J24.2, R71.2
unnamed: LED5.2 (A), U7.2
unnamed: LED6.2 (A), U8.2
unnamed: LED7.2 (A), U9.2
unnamed: LED8.2 (A), U10.2
unnamed: LED9.2 (A), U11.2
unnamed: LED10.2 (A), U12.2
unnamed: Q2.1 (B), R45.1
unnamed: Q3.1 (B), R47.1
unnamed: Q4.1 (B), R49.1
unnamed: Q5.1 (B), R51.1
unnamed: Q6.1 (B), R53.1
unnamed: Q7.1 (B), R55.1
unnamed: R44.2, U7.1
unnamed: R45.2, U7.3
unnamed: R46.2, U8.1
unnamed: R47.2, U8.3
unnamed: R48.2, U9.1
unnamed: R49.2, U9.3
unnamed: R50.2, U10.1
unnamed: R51.2, U10.3
unnamed: R52.2, U11.1
unnamed: R53.2, U11.3
unnamed: R54.2, U12.1
unnamed: R55.2, U12.3
unnamed: R61.1, R62.1, U13.2 (-)
unnamed: R64.1, R65.1, U13.6 (-)

Notes on the sheet:
R.STO -> PD.0 R.EN -> PD.1 R.DIR -> PD.2 L.STO -> PD.3 L.EN -> PD.4 L.DIR -> PD.5

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
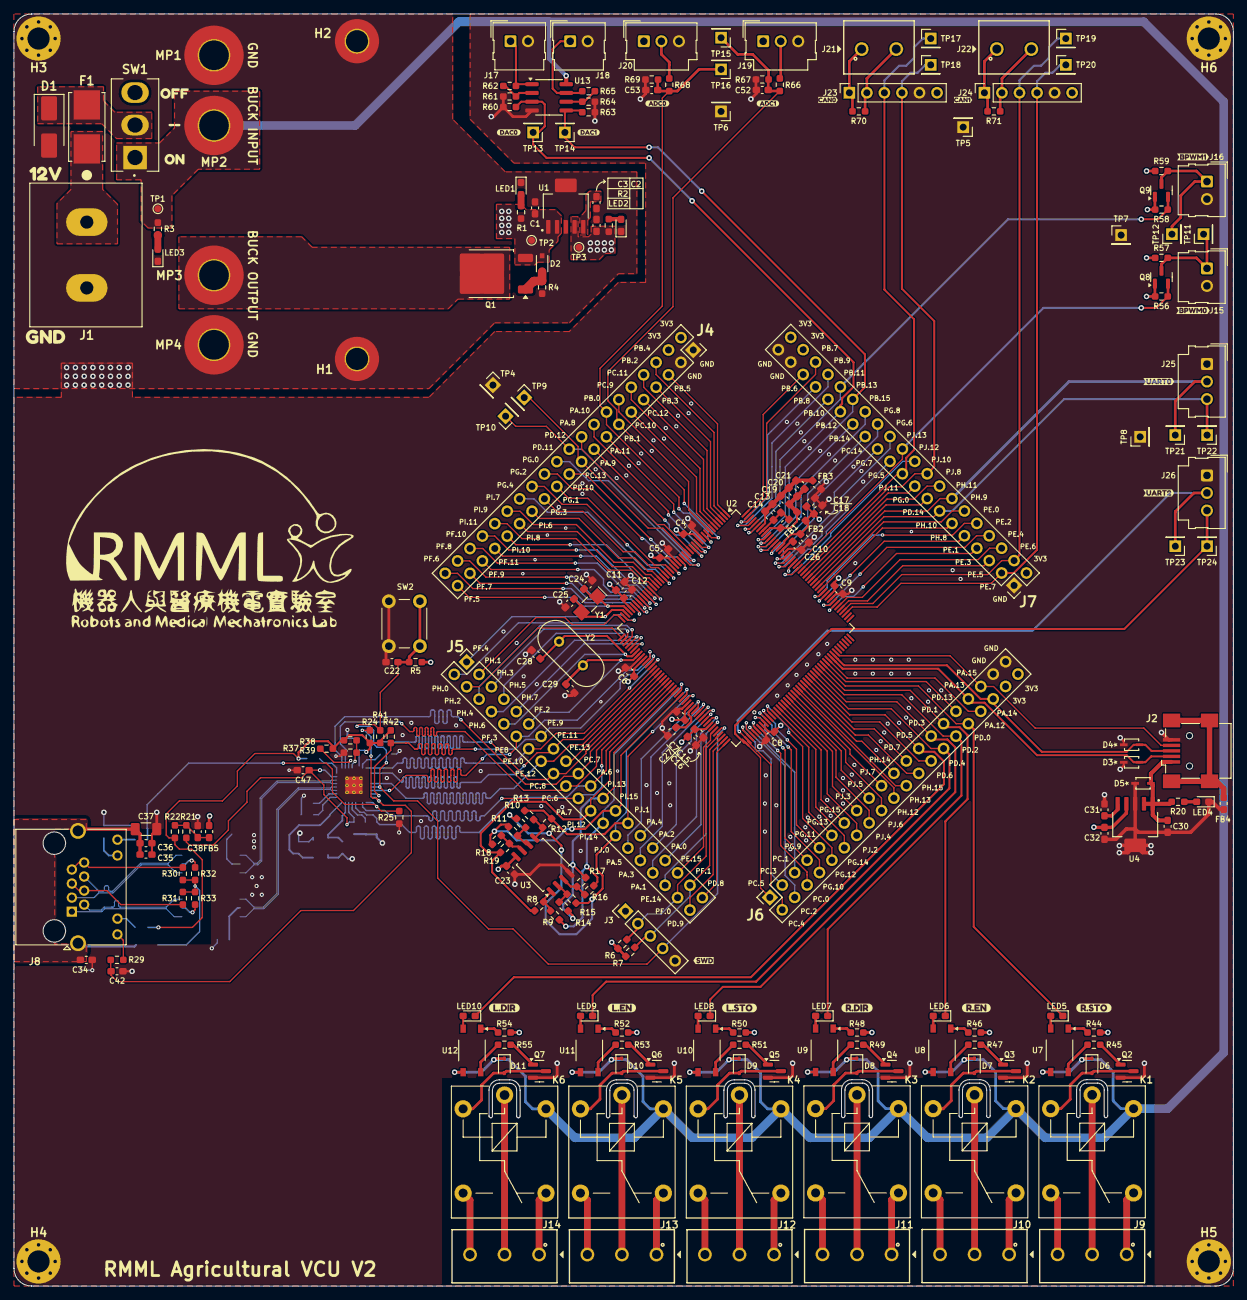
[picture p35: board UGV Control Unit.kicad_pcb from above]

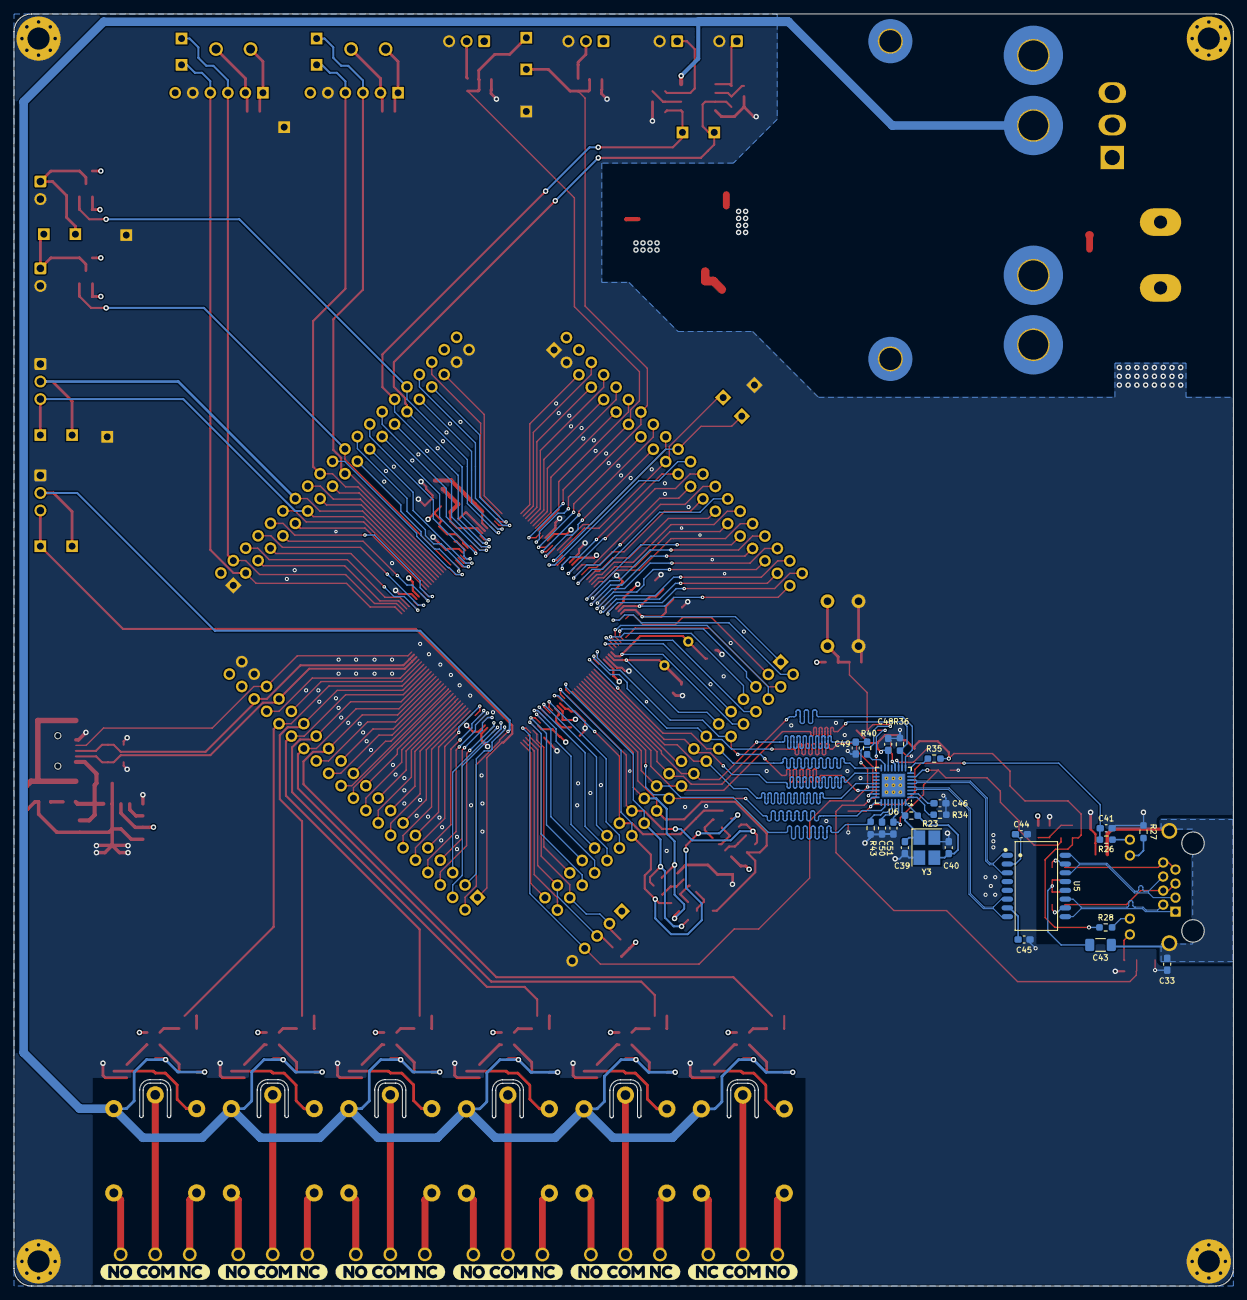
[picture p36: board UGV Control Unit.kicad_pcb from below]

Board: 4 copper layers, 176.5 x 184.2 mm, 272 parts (30 on the bottom side), 268 nets.

Other parts of the board:
kibuzzard-69F96702: G***; kibuzzard-69F96702
kibuzzard-69634B4E: G***; kibuzzard-69634B4E
kibuzzard-69634B5D: G***; kibuzzard-69634B5D
kibuzzard-69634B7E: G***; kibuzzard-69634B7E
kibuzzard-69634B14: G***; kibuzzard-69634B14
kibuzzard-69634B71: G***; kibuzzard-69634B71
kibuzzard-69634B86: G***; kibuzzard-69634B86
kibuzzard-69634D58: G***; kibuzzard-69634D58
kibuzzard-69634DF9: G***; kibuzzard-69634DF9
kibuzzard-69634E28: G***; kibuzzard-69634E28
kibuzzard-69634F3E: G***; kibuzzard-69634F3E
kibuzzard-69634F68: G***; kibuzzard-69634F68
kibuzzard-696343CD: G***; kibuzzard-696343CD
kibuzzard-696344FB: G***; kibuzzard-696344FB
kibuzzard-696346AD: G***; kibuzzard-696346AD
kibuzzard-696346DC: G***; kibuzzard-696346DC
kibuzzard-6963491B: G***; kibuzzard-6963491B
kibuzzard-6963492B: G***; kibuzzard-6963492B
kibuzzard-69634563: G***; kibuzzard-69634563
kibuzzard-69634575: G***; kibuzzard-69634575
kibuzzard-69634733: G***; kibuzzard-69634733
kibuzzard-69635000: G***; kibuzzard-69635000
kibuzzard-69635019: G***; kibuzzard-69635019
kibuzzard-69641404, kibuzzard-69641404#2, kibuzzard-69641404#3, kibuzzard-69641404#4, kibuzzard-69641404#5: G***; kibuzzard-69641404
